rbtsco/StickHub/CAM/StickHub-B.png

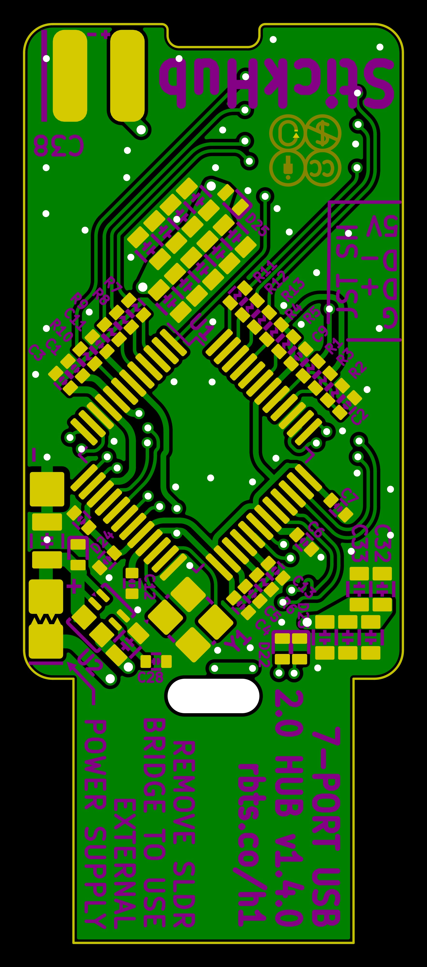
CAM/StickHub-B.png
