rbtsco/StickHub/CAM/StickHub-F.png

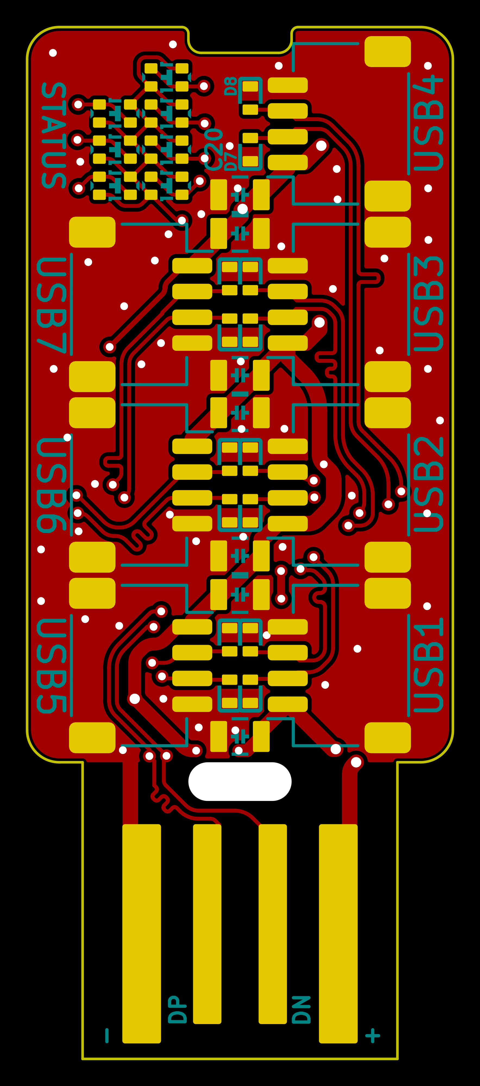
CAM/StickHub-F.png
