rbtsco/StickHub/Schematic.png

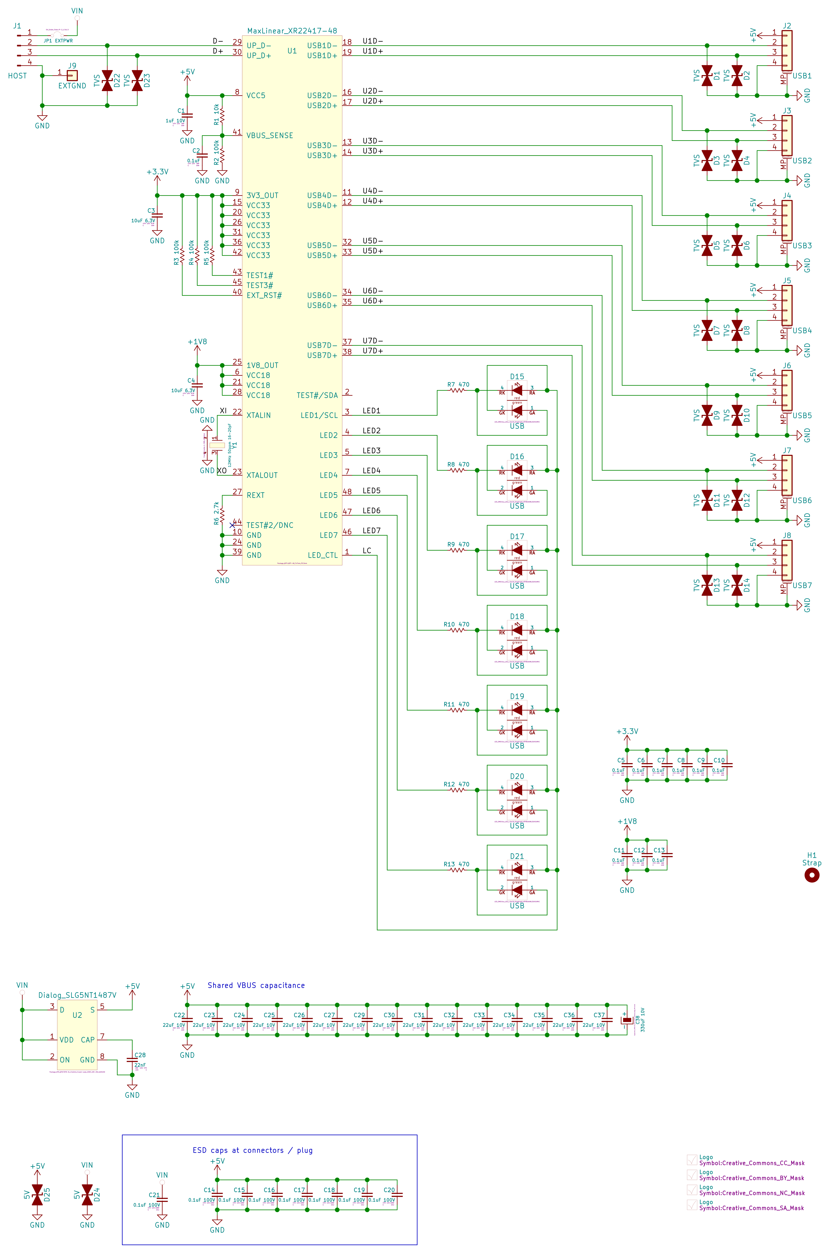
Schematic.png
