rbtsco/StickHub/BOM.png

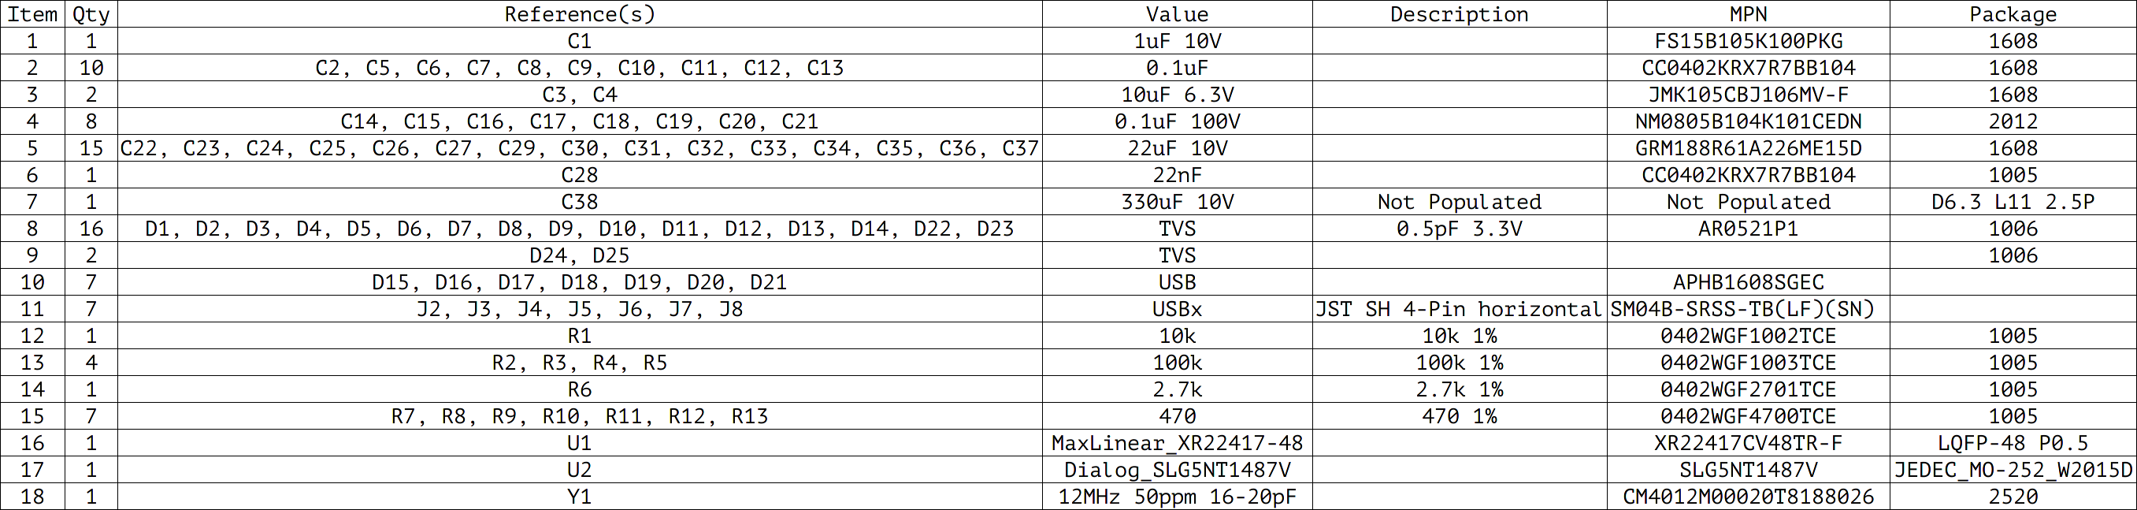
BOM.png
