rbtsco/StickHub/(commit log)

2020-10-20 v1.3.3: Fix bug where the Dialog 'ON' pin was connected to it's own output.
    [StickHub-B_Adhesive.gbr, StickHub-B_Cu.gbr, StickHub-B_Mask.gbr, StickHub-B_Paste.gbr, StickHub-B_Silkscreen.gbr, StickHub-Edge_Cuts.gbr, StickHub-F_Adhesive.gbr, StickHub-F_Cu.gbr]
2020-10-22 Fix bug with enable + optional cap
    [StickHub-B_Adhesive.gbr, StickHub-B_Cu.gbr, StickHub-B_Mask.gbr, StickHub-B_Paste.gbr, StickHub-B_Silkscreen.gbr, StickHub-Edge_Cuts.gbr, StickHub-F_Adhesive.gbr, StickHub-F_Cu.gbr]
2020-10-23 Exclude some useless files
    [StickHub.kicad_pcb, StickHub.old.csv]
2020-11-07 v1.4.0: TVSs for +5V and Vin + curvy traces
    [StickHub-B_Adhesive.gbr, StickHub-B_Cu.gbr, StickHub-B_Mask.gbr, StickHub-B_Paste.gbr, StickHub-B_Silkscreen.gbr, StickHub-Edge_Cuts.gbr, StickHub-F_Adhesive.gbr, StickHub-F_Cu.gbr]
2021-01-13 CAM files as used for PCBA
    [StickHub-B_Adhesive.gbr, StickHub-B_Cu.gbr, StickHub-B_Mask.gbr, StickHub-B_Paste.gbr, StickHub-B_Silkscreen.gbr, StickHub-Edge_Cuts.gbr, StickHub-F_Adhesive.gbr, StickHub-F_Cu.gbr]
2021-01-20 Fix incorrect part number on C28, fix BOM package fields, switch 10uF 6.3V 0402 MPN
    [StickHub.csv, StickHub.kicad_sch]
2021-01-23 Swapped 3D models downloaded from JST for self-drawn clones
    [StickHub.kicad_pcb]
2021-01-26 Replace obsolete 3D models with standard libary ones. Update LED fab layer to assist board inspection
    [StickHub-B_Adhesive.gbr, StickHub-B_Cu.gbr, StickHub-B_Fab.gbr, StickHub-B_Mask.gbr, StickHub-B_Paste.gbr, StickHub-B_Silkscreen.gbr, StickHub-Edge_Cuts.gbr, StickHub-F_Adhesive.gbr]
